DevAndresMauro/project-bioho/docs/hardware/led_rail.md

# LED rail: a six-pixel status bar

One uncut 6-LED segment of SK6812 RGBW strip - **one pixel per swarm member**,
driven by the display DevKitC. The joint technique is `soldering.md`'s joint section; the
rail-specific work is expanded move-by-move in
[`led/wire_strip_work.md`](led/wire_strip_work.md),
[`led/shifter_board.md`](led/shifter_board.md) and
[`led/first_light.md`](led/first_light.md). The firmware side is
already built into `firmware/display/` - the colour law lives in
[`../firmware/display_led.md`](../firmware/display_led.md).

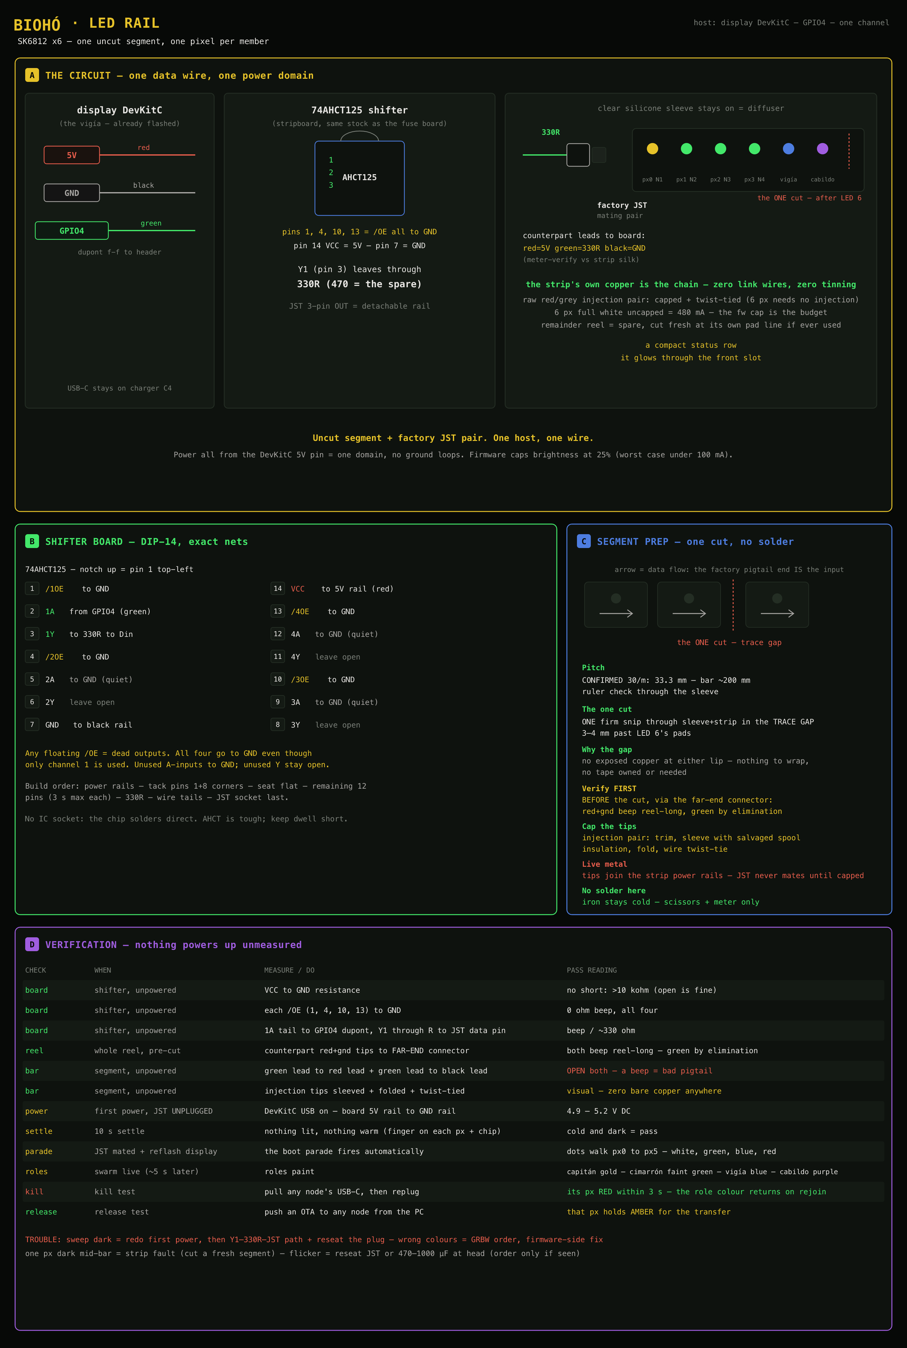
[picture p4: docs/hardware/led/diagrams/led-rail.png]
The LED rail sheet


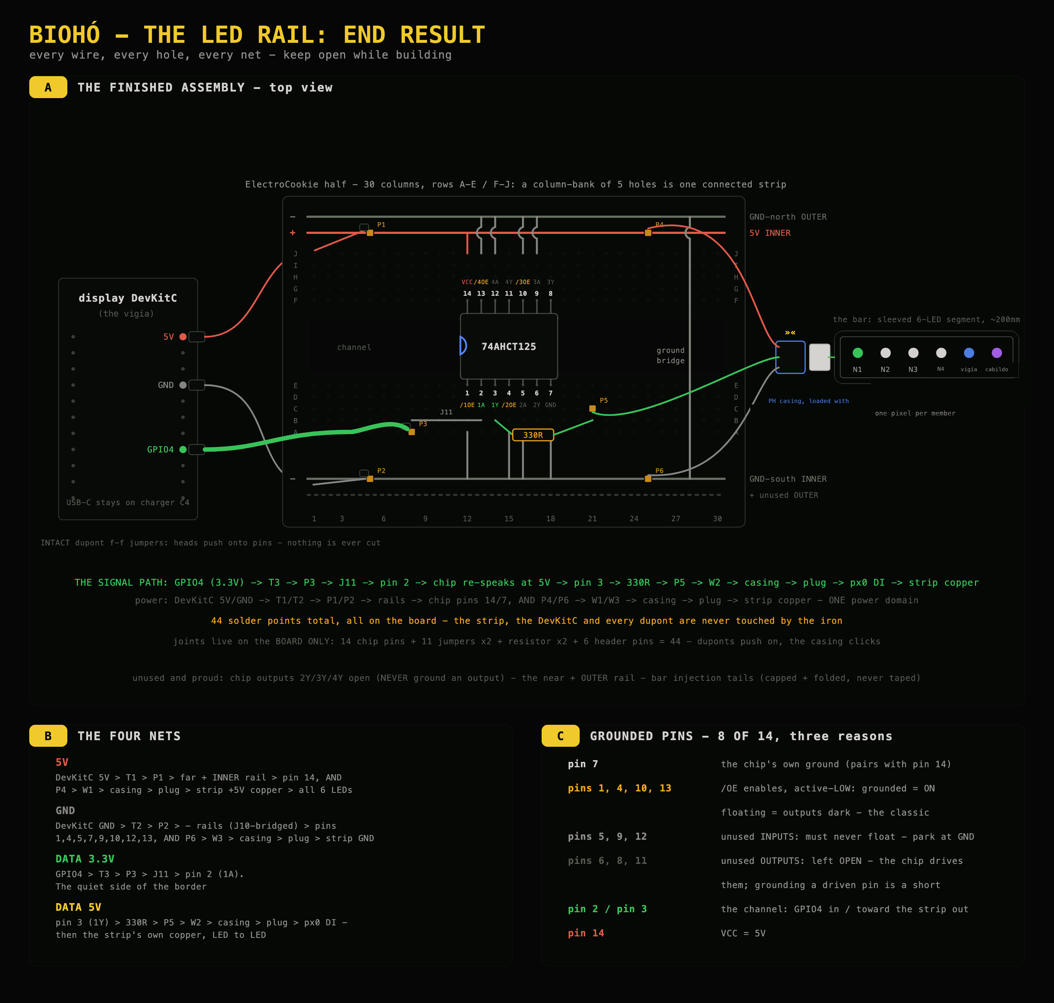
[picture p5: docs/hardware/led/diagrams/led-endstate.png]
The end result, every wire and hole


The strip's own copper is the chain; its **factory plug is the detachable head
link** - no loose mating half ships with the strip, so the board presents a PH
casing loaded with extracted dupont contacts, and the plug clicks onto that.
The clear silicone sleeve stays on as the diffuser.

## Decisions, with reasons

| Decision | Why |
|---|---|
| **Host = the display DevKitC**, data **GPIO4** | The witness already knows the whole roster; free GPIO; USB-flashable in seconds; no serving duties to disturb. GPIO4 is unused (TFT = 7-12, touch loom = 1, 2, 41, 42) and not a strapping pin. |
| **ONE data channel** through AHCT125 ch-1 | One wire, one host; one channel of the chip's four is enough. |
| **Power from the DevKitC 5V pin** | One power domain = guaranteed common ground, no loop through a second charger port (a longer rail would need its own feed). |
| **Brightness capped in firmware** | 6 px full white = 480 mA; capped worst case is well under 100 mA on the same USB-C feed as the TFT. The power budget is software, enforced at the driver (`BRIGHT_CAP` in `led.c`). |
| **SK6812 RGBW = 32-bit GRBW** | Not a plain WS2812. `led.c` already speaks GRBW; scrambled colours are a firmware-side report, not a solder problem. |

## Parts

- the SK6812 RGBW strip - ONE 6-LED segment comes off the reel (cut in the
  plain trace gap 3-4 mm past LED 6's pads), sleeve kept, factory plug kept
- 1× 74AHCT125 DIP-14 + an ElectroCookie half board
- one **330 Ω** resistor (anything 250-600 works, tolerance irrelevant)
- solid-core wire: red / green / black; one bare 3-pin PH casing, loaded with
  contacts extracted from intact dupont jumpers
- 6× intact F-F duponts (three DevKitC-side, three casing-side)
- iron + 63/37 solder, wire strippers, the multimeter
- only if flicker is ever actually observed: a 470-1000 µF electrolytic at the
  head of the strip

## Build, in order

1. **Strip work** (`led/wire_strip_work.md`): verify the pigtail mapping
   end to end with the meter, cut through sleeve AND strip in the trace gap
   past LED 6, cap the raw injection tips with salvaged insulation and a wire
   twist-tie. No pad tinning, no link wires - the factory pigtail is the loom.
2. **The shifter board** (`led/shifter_board.md`): the 74AHCT125 at
   columns 12-18 notch-left, 8 pins to GND (pin 7, the four /OE, three unused
   inputs), eleven jumpers including the ground bridge, the 330 Ω off pin 3,
   and six header pins P1-P6. The only soldering in the rail project. No
   dupont jumper is ever cut - heads push onto pins.
3. **Hookup + first light** (`led/first_light.md`): three intact duponts
   DevKitC 5V/GND/GPIO4 ↔ P1/P2/P3, a voltage check with the bar unplugged,
   click the loaded casing onto the bar's plug, reflash the display, watch the
   boot parade walk px0 → px5.

## Firmware

`firmware/display/main/led.c`: `espressif/led_strip` over RMT, GPIO4, 6 px,
GRBW, one global brightness cap. `led_init()` runs the boot parade;
`led_render()` paints at 4 Hz from the same snapshot the TFT reads at 1 Hz.
The colour law - lost red, booting a fast white blink, release a slow white
blink, benched solid white, the capitán gold `#e6c229`, a serving cimarrón faint
green, the vigía deepest blue, the cabildo deepest purple - is written out in
[`../firmware/display_led.md`](../firmware/display_led.md). With no
rail attached it is electrically inert - a display build carries it whether
or not the bar is plugged in, so the reflash can happen before or after the
soldering.
