DevAndresMauro/project-bioho/assets/og.png

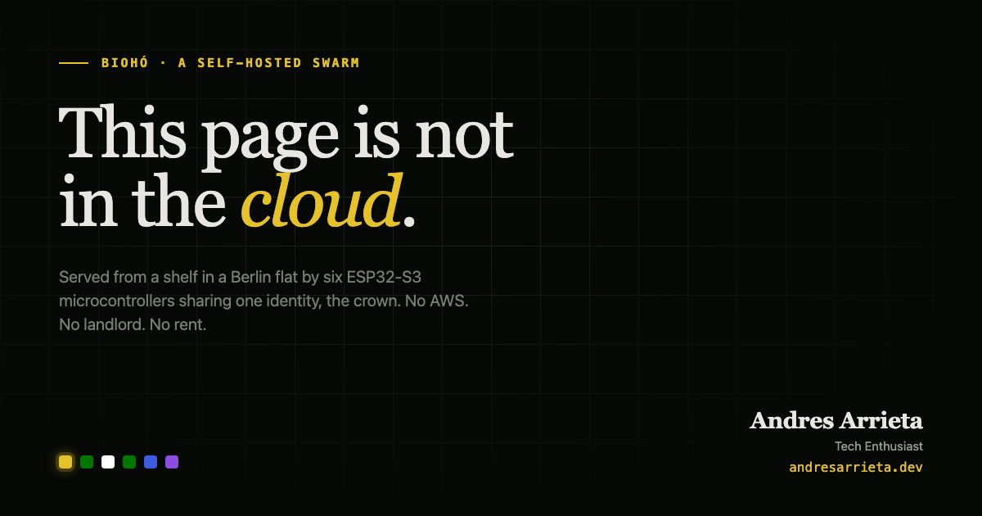
assets/og.png
