DevAndresMauro/project-bioho/firmware/mission/assets_src/palenque_seal_baked.png

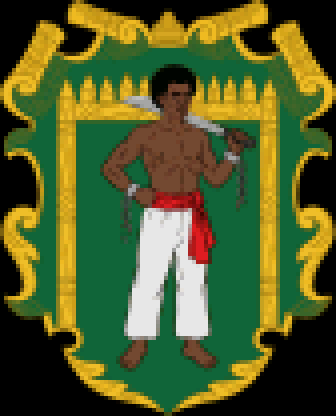
firmware/mission/assets_src/palenque_seal_baked.png
