DevAndresMauro/project-bioho/docs/hardware/BOM.md

# Bill of materials

The standing parts list is maintained at the repository root:

**[`../../BOM.md`](../../BOM.md)**
