DevAndresMauro/project-bioho/hardware/stl/shell_bottom.stl

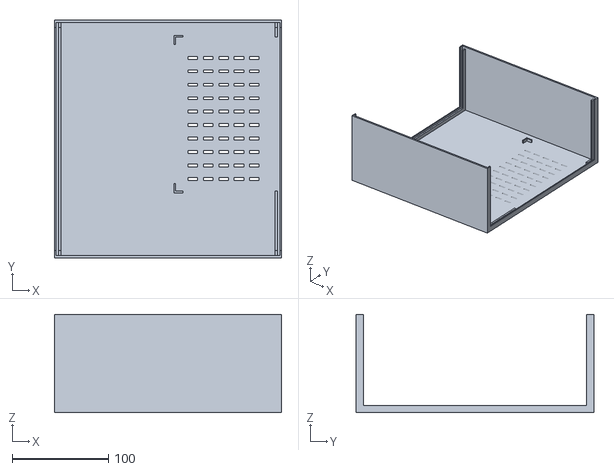
[picture p14: CAD file, 2026-10-28]
hardware/stl/shell_bottom.stl
236.0 x 247.0 x 102.4
