DevAndresMauro/project-bioho/hardware/stl/shell_front_back.stl

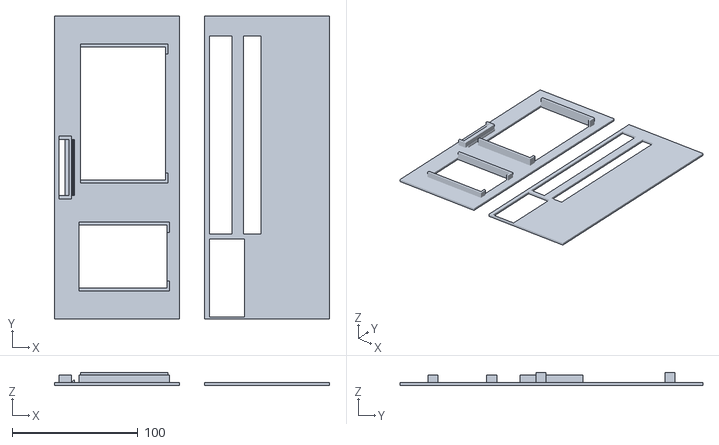
[picture p15: CAD file, 2026-10-28]
hardware/stl/shell_front_back.stl
219.2 x 241.4 x 10.4
