DevAndresMauro/project-bioho/hardware/stl/shell_top.stl

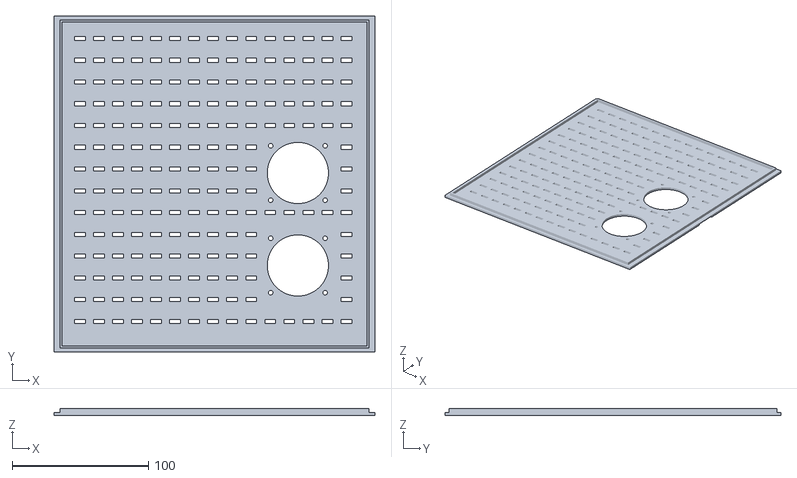
[picture p16: CAD file, 2026-10-28]
hardware/stl/shell_top.stl
236.0 x 247.0 x 5.40
