DevAndresMauro/project-bioho/hardware/stl/plate.stl

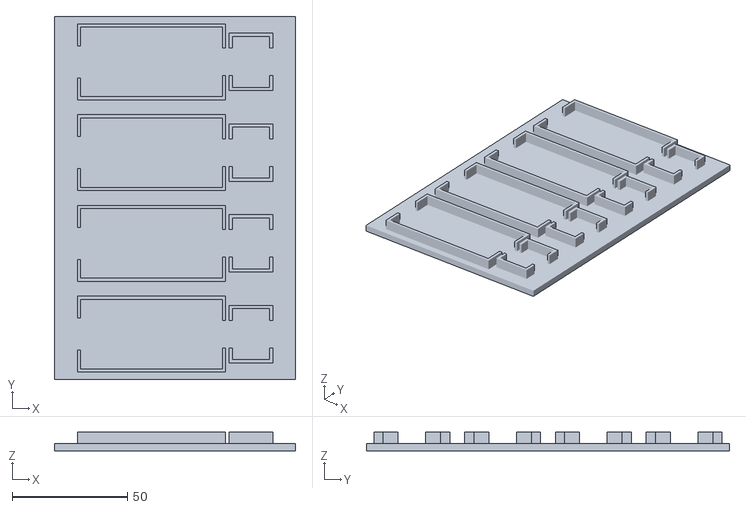
[picture p17: CAD file, 2026-10-28]
hardware/stl/plate.stl
104.9 x 157.7 x 8.20
