DevAndresMauro/project-bioho/(commit log)

2026-10-28 Bring the Biohó machine onto this fork.
    The shelf build replaces the kurin rack: one plate, one shell, and the names the fleet uses now.
    [kurin.scad, kurin_base_v4.stl, kurin_lid_v4.stl, partitions.csv, plate.scad, plate.stl, shell.scad, shell_bottom.stl]
2026-10-30 Drop the status column from the bill of materials.
2026-10-30 eth v18: keep a day of die temperatures and stop warm-idle and crown-claim flaps.
    Move TLS record buffers to PSRAM, shorten the OTA trial to 60 s, and drop the power-order demo from the docs.
    [blackbox.c, crown.c, crown.h, eth_main.c, logic.h, selftest.c, serve.c, swarm.c]
